sumanbhatbtech25-beep/Self-SOLAR-TrackingandCleaning/docs/images/wiring-schematic.png

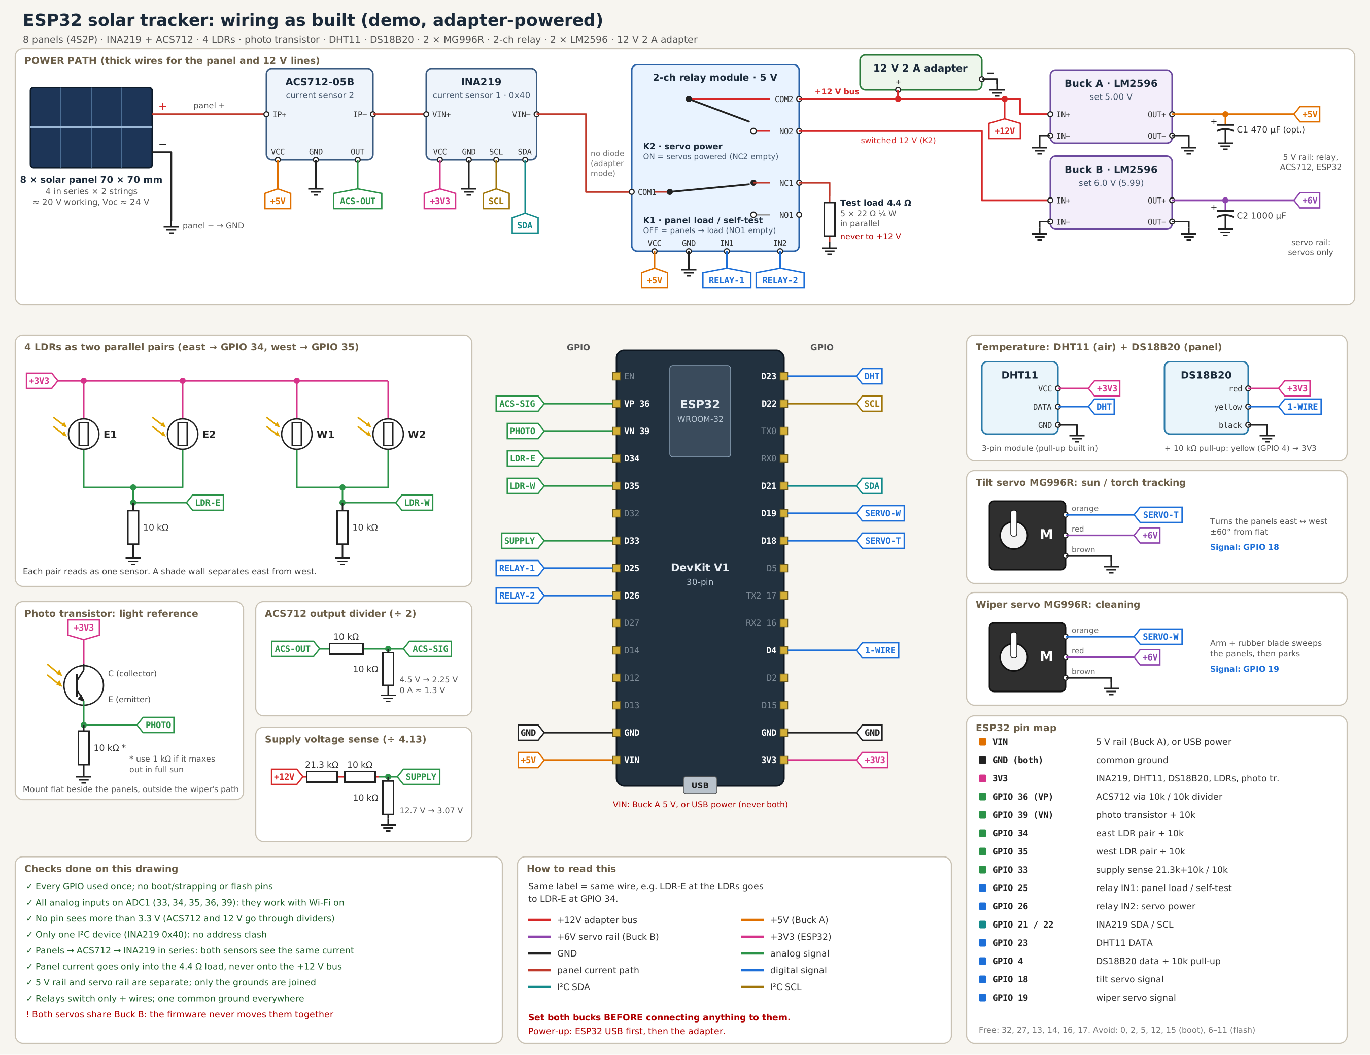
docs/images/wiring-schematic.png
