sumanbhatbtech25-beep/Self-SOLAR-TrackingandCleaning/firmware/solar_tracker/commands.h

// commands.h — text commands, shared by the Serial Monitor, the dashboard and
// the phone (ThingSpeak TalkBack).
#pragma once
#include <Arduino.h>

namespace Commands {
  // Runs one command line, e.g. "label E2_light_s1" or "clean". Returns a reply.
  String run(String line);
  void printHelp();
  void service();     // call every loop: carries out a requested restart
}
