sumanbhatbtech25-beep/Self-SOLAR-TrackingandCleaning/(commit log)

2026-11-07 Update circuit diagram to the current demo build (#5)
    Adapter-powered build: ACS712 + INA219 in the panel line, relay 1 switching
    the panels to a 4.4 ohm test load, relay 2 switching Buck B for the servos,
    LDR pairs on GPIO 34/35, photo transistor on 39, supply sense on 33,
    DHT11 on 23 and DS18B20 on 4. Adds a PNG copy and updates the README pin table.
2026-11-10 Firmware v0.5, experiment protocol and analysis pipeline (#6)
    - Firmware rewritten for the demo rig: adapter supply, INA219 + ACS712 in series,
    LDR pairs on GPIO 34/35, photo transistor light reference, DS18B20, DHT11,
    relays on GPIO 25/26, tilt and wiper servos on GPIO 18/19
    - Light-referenced dust check (Rule B) with the current-only ratio (Rule A) logged
    alongside; relay self-test; 18 fault rules; demo and normal timing
    - 1-second CSV log with experiment labels and marks; Serial and dashboard commands
    - tests/calibration sketch, experiments/PROTOCOL.md (E1-E6), analysis/ with
    capture, analysis, figures, LaTeX tables and a watermarked synthetic test mode
2026-11-10 Add ThingSpeak upload and TalkBack phone commands (#7)
    Uploads 8 fields plus fault status and polls TalkBack in a background task on
    core 0, so tracking is never stalled by slow internet. Keys go in secrets.h.
    [cloud.cpp, cloud.h, config.h, secrets.example.h, solar_tracker.ino, web.cpp]
2026-11-10 Firmware v0.6: all readings to ThingSpeak, remote tests, phone page (#8)
    - LIVE and HEALTH ThingSpeak channels carry every sensor reading; faults,
    test results and command replies go in the status text
    - Remote tests (sensors, tilt sweep, wiper, full) and stop/upload/reboot
    from the phone (TalkBack), the dashboard and Serial
    - Cleaning levels the panel under the fixed wiper first; tilt moves are
    slewed one degree at a time
    - Cloud task reads a mutex-protected snapshot (no String shared between cores)
    - docs/phone/index.html phone page
    [app_state.h, cleaner.cpp, cleaner.h, cloud.cpp, cloud.h, commands.cpp, commands.h, config.h]
