sumanbhatbtech25-beep/Self-SOLAR-TrackingandCleaning/(notices)

Notices in the files:
README.md:
License: MIT
